WWnotLL/ROS2_tutorial_305/Инструкция по сборке/README.md

# Инструкция по сборке робота BOX305
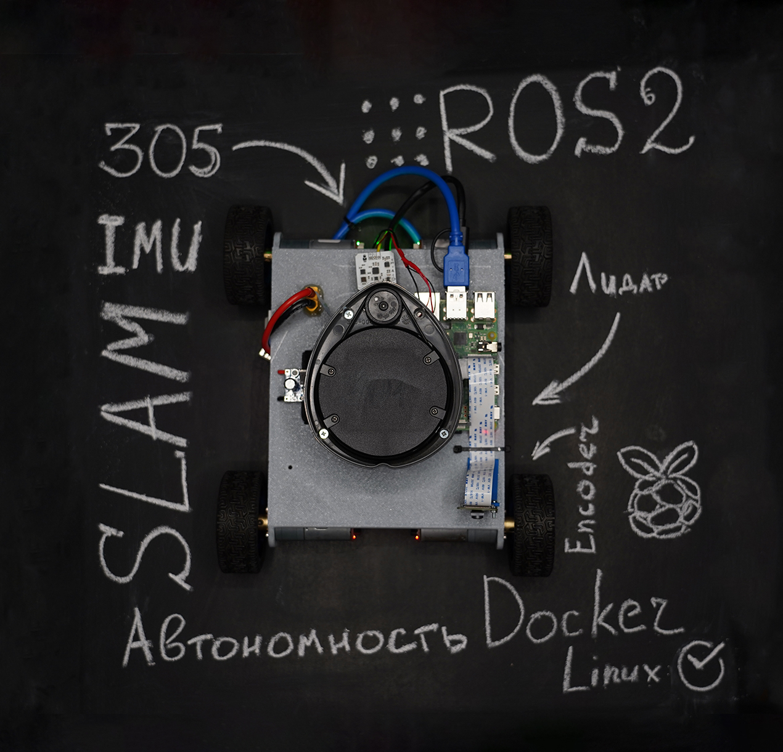
[picture p8: Визитка робота.jpg]

## Вам понядобится следующий набор инструментов
  - Паяльник (думаю понятно для чего 🤔)
  - Дрель (для сверления крепежных отверстий 👍)
  - Клеевой пистолет (на случай, если увлеклись сверлением 🙊)
  - Отвертки (скорее всего PH0 и PH00, но зависит от использованных винтиков 🤷‍♂️)
  - Шестигранники (если не хватит обычных винтиков 😎)
## Корпус

Модель корпуса нашего робота выглядит следующим образом
<br>
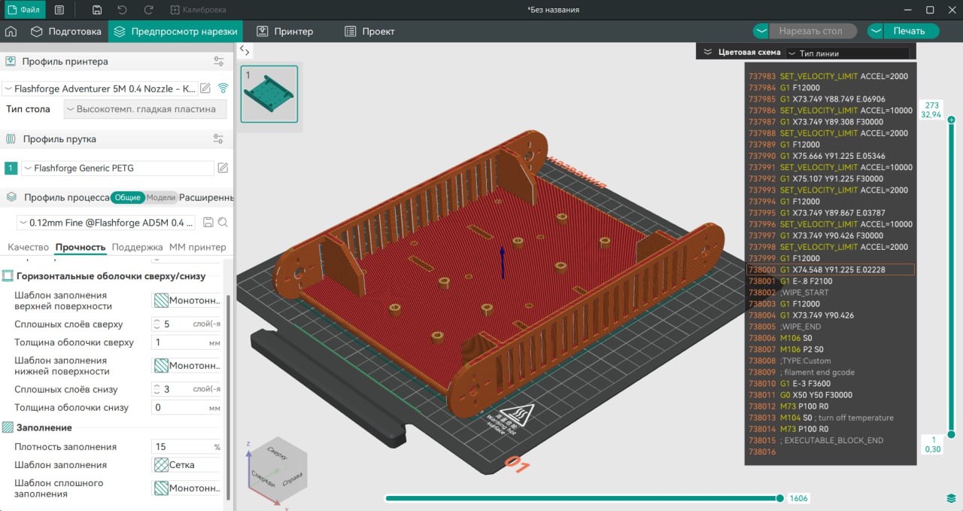
[picture p9: Инструкция по сборке/Иллюстрации к сборке/06_BOX305_модель корпуса.jpg]

<br>
 

Если нет собственных "производственных мощностей", всегда можно воспользоваться услугами __[студий 3D печати](https://uslugi.yandex.ru/213-moscow/category/raznoe/poligraficheskie-uslugi/3dpechat--5635)__

В случае выбора лёгкого пути, смело можно пропускать данный раздел

Для печати корпуса необходим 3D принтер с рабочим полем $200 \times 200$ мм

Выбор материала

Краткая информация об основных видах пластика

| **Параметр** | **ABS** | **PLA** | **PETG** |
|---|---|---|---|
| **Печать** | Капризен, требует закрытого бокса и вентиляции | Очень прост, идеален для новичков | Умеренно прост, требует настройки |
| **Прочность** | Прочный, ударостойкий | Жесткий, но хрупкий при ударе и холоде | Прочный, гибкий, устойчив к излому |
| **Темп. стойкость** | Высокая (-40…+80 °C) | Низкая (~50 °C, "плывёт" на солнце) | Средняя (~80 °C), подходит для большинства задач  |
| **Нетоксичность** | ❌ (выделяет вредные пары) | ✅ (безопасен, с запахом жареной еды) | ✅ (не пахнет, безопасен) |

Для нашего робота будем использовать **PETG**

Для печати корпуса воспользуемся специальной программой __[OrcaSlicer](https://orcaslicer.com/)__

Выставим основные параметры печати следующими:

- Температура экструзии — 215-245°C;

- Температура стола — 20-80°C;

- Процент заполнения — 15%;

## Устанока навесных компонентов

1) Начнём с установки двигателей и колёс.

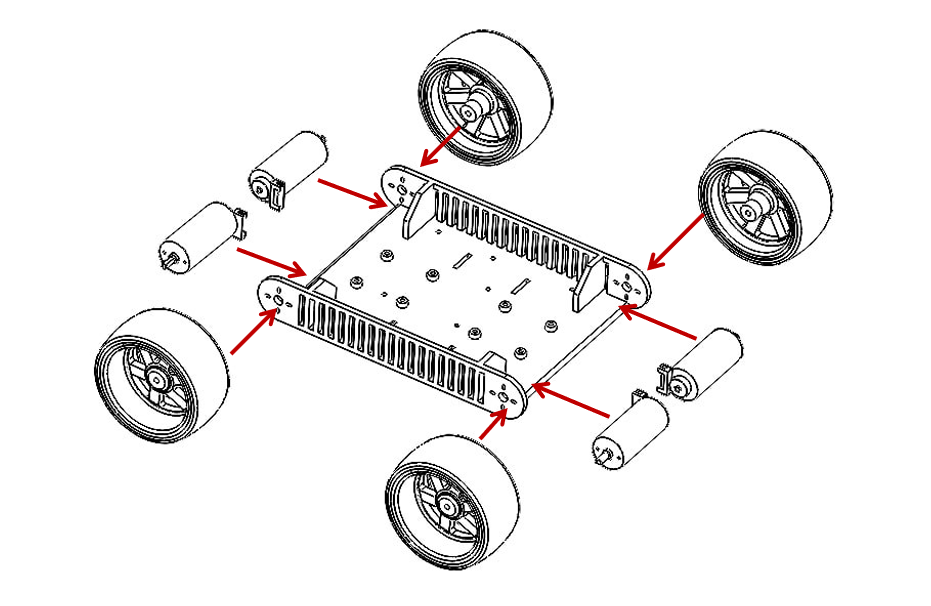
[picture p10: Инструкция по сборке/Иллюстрации к сборке/01_BOX305_разобранный.png]


2) Далее монтируем стойки для установки __raspberry 4__, __лидара__, __DC-DC преобразователя__ и __arduino nano__.
3) Подготавливаем крепление для аккумулятора, мы использовали липучки (прямоугольные вырезы на фото ниже).
4) Устанавливаем разъём подключения аккумулятора XT60 и кнопку питания, спаиваем их
5) Далее приступаем к установке драйверов.

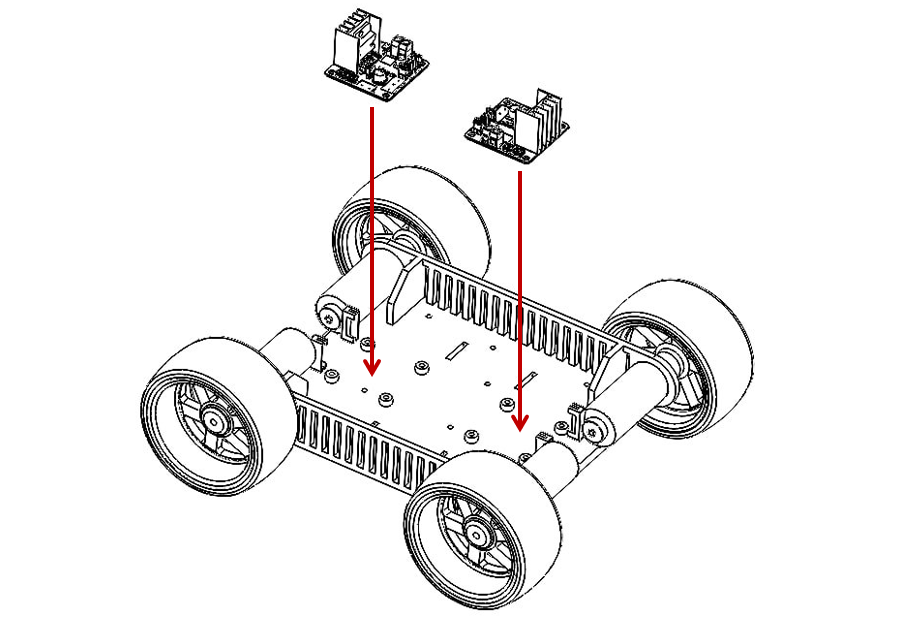
[picture p11: Инструкция по сборке/Иллюстрации к сборке/02_BOX305_установка драйверов.png]
 

6) Монтируем arduino и DC-DC преобразователь
7) Настраиваем преобразователь на **5В**
8) Припаиваем питание к преобразователю и от него к arduino
9) Протягиваем и припаиваем провода от двигателей к драйверам и arduino
10) Устанавливаем Raspberry

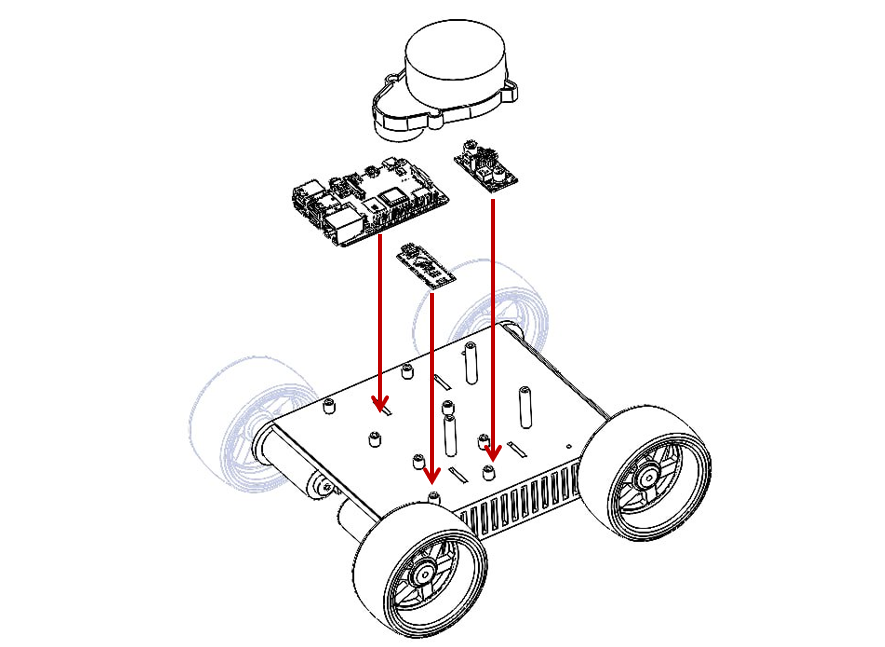
[picture p12: Инструкция по сборке/Иллюстрации к сборке/03_BOX305_установка электроники.png]


11) Наслаждаемся собранным роботом

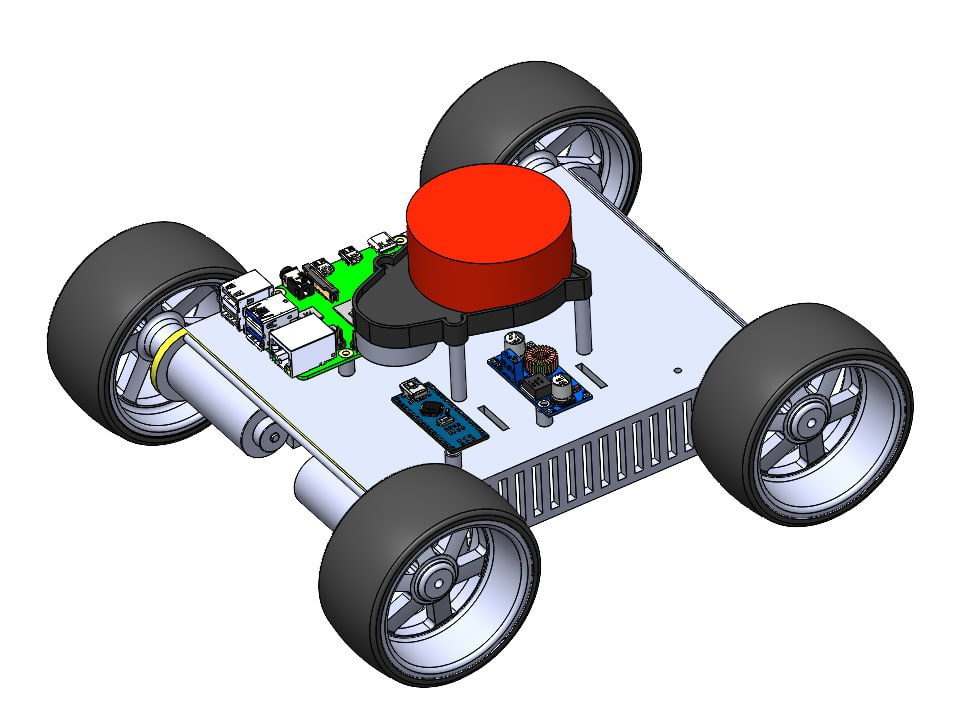
[picture p13: Инструкция по сборке/Иллюстрации к сборке/05_BOX305_модель.jpg]
