WWnotLL/ROS2_tutorial_305/Docker/README.md

# Docker. Краткая информация
__Docker__ — это платформа с открытым исходным кодом для автоматизации разработки, доставки и развёртывания приложений.<br>
<br>
__Контейнер в Docker__ — это изолированное пространство, которое позволяет запускать приложения с их зависимостями отдельно от основной системы. В отличие от традиционных виртуальных машин, контейнеры потребляют меньше ресурсов, так как используют ядро основной системы.<br> 
<br>
Установочный файл __[Docker](https://docker.qubitpi.org/desktop/setup/install/windows-install/)__ <br>
Обратите внимание что при установке необходимо обязательно установить опцию `Use the WSL 2 based engine`. <br>
После установки Docker необходимо зайти в настройки<br>
<br>
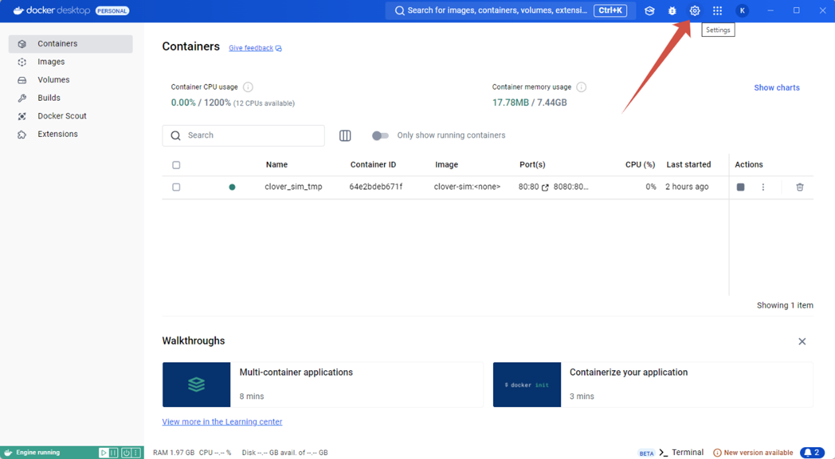
[picture p20: изображения к тексту/настройки докера.png]
Настройки докера
 

<br>

И в пункте __Resources__ подпункте __WSL integration__ проверить что для вашего дистрибутива интеграция включена.
Для работы в самом симуляторе нам потребуется __IDE VS Code c модулем DEV Containers__. Для установки __[VS Code](https://code.visualstudio.com/)__ скачайте установщик по ссылке и запустите его с параметрами по умолчанию
Для установки расширения необходимо запустить __VS Code__ и перейти в раздел __«Расширения» (Ctrl+Shift+X)__. В строке поиска введите __“Remote Development”__ и установите это расширение.

Для более подробного изучения __[Docker](https://github.com/WWnotLL/ROS2_tutorial_305/blob/main/Docker/Docker.docx)__ перейдите по ссылке. <br>
Пример, показывающий как запустить рабочий контейнер, смотрите __[здесь](https://github.com/WWnotLL/ROS2_tutorial_305/blob/main/Docker/Запуск_рабочего_контейнера_Краткая_инструкция.md)__
