WWnotLL/ROS2_tutorial_305/ROS2.md

# ROS (Robot Operating System)<br>
*__Robot Operating System (ROS)__* - это фреймворк (гибкая платформа) для разработки программного обеспечения (ПО) роботов, который ставится на базовую операционную систему, обычно на Linux (Ubuntu).<br>
ROS можно рассматривать, как набор разнообразных инструментов, библиотек и определенных правил, целью которых является упрощение задач разработки ПО роботов.<br>
Он был создан, чтобы стимулировать совместную разработку программного обеспечения робототехники.<br>
Каждая отдельная команда разработчиков и энтузиастов может работать над какой-либо конкретной задачей, но использование единой платформы, позволяет всему сообществу получить и использовать результат их работы для своих личных проектов. <br>
# ROS2 <br>
ROS2 использует те же принципы работы, что и ROS1. В то же время, ROS2 не является частью ROS1. <br>
В отличие от ROS1, cтек которого написан на C++, а клиентские библиотеки на C++ и Python, в ROS2 также используется язык C. <br>
Преимущества использования ROS2: <br>
- позволяет устанавливать безопасные соединения между компонентами системы (нодами);
- взаимодействие осуществляется в режиме «real-time»;
- соединение нескольких роботов в одну сеть упрощен;
- улучшено «качество общения» между нодам (узлами или по простому небольшими командами);<br>

ROS2 реализует real-time взаимодействие через так называемую концепцию DDS (Data Distributed Services) - набор алгоритмов, встраиваемых к разным программам, позволяющий всем программам, имеющим встроенный блок, общаться между собой без центрального сервера.<br>
Для генерации исходного кода для сообщений на разных языках используется протокол ROS MSG. <br>
Для передачи данных между программами существуют следующие инструменты:<br>
1) Топики (topics) – это базовый способ взаимодействия между программами, в этом случае есть программы публикующая (publisher) данные в топик, а есть получающие (subscriber) данные.<br>
Не публикующие и не получающие данные программы ничего не знают об остальных программах, взаимодействующих с топиком. Эта особенность позволяет заменять данные без влияния на другие программы. Например, у нас могут поддерживаться разные инерциальные модули, для каждого из которых существует программа, публикующая данные в один и тот же топик в одном и том же формате.<br>


3) Сервисы – это это механизм синхронного (одновременного) или асинхронного (неодновременного, да-да, логично) вызова процедур между нодами. Они позволяют одной ноде вызывать функцию, которая выполняется в другой ноде.<br>
Сервис состоит из двух компонентов:<br>
- Клиент – компонент, формирующий запрос, отправляющий его серверу и ожидающий ответа.<br> 
- Сервер – компонент, получающий запрос, завершающий вычисление и отправляющий ответ клиенту.<br>

Сервисы часто используются для быстрых задач, которые требуют немедленного ответа.<br>


3) Действия (Actions) в ROS — это механизм связи, предназначенный для управления длительными задачами в распределённой робототехнической системе.<br>
Действия состоят из двух компонентов:<br>
Клиент действия — узел, который запрашивает выполнение цели от своего имени. Он ожидает обратной связи и результата по завершении.<br>
Сервер действий — узел, который принимает цель и выполняет необходимые процедуры. Он отправляет обратную связь по мере выполнения действия и возвращает полный результат, когда цель достигнута.<br>


Дополнительные инструменты, доступные в ROS:
1) Rqt_gui – графический интерфейс представляющий из себя набор плагинов, позволяющий анализировать запущенное окружение ROS.
2) Node Graph – один из плагинов rqt_gui, позволяющий посмотреть запущенные программы и то, как они между собой взаимодействуют.
3) RVIZ – инструмент визуализации стандартных сообщений ROS. 
4) Nav2 – набор программ, используемый для навигации робота, его перемещения и предотвращения столкновении.
