WWnotLL/ROS2_tutorial_305/Docker/Установка Docker на Ubuntu.md

# Инструкция по запуска Docker
<br>
## Дисклеймер
### В основном в этой инструкции будут представлены картинки успешного выполнения команды, в иных случаях будет дано более подробное описание к картинкам
1. Для начала обновите список пакетов и установите обновления:

```
sudo apt update
```

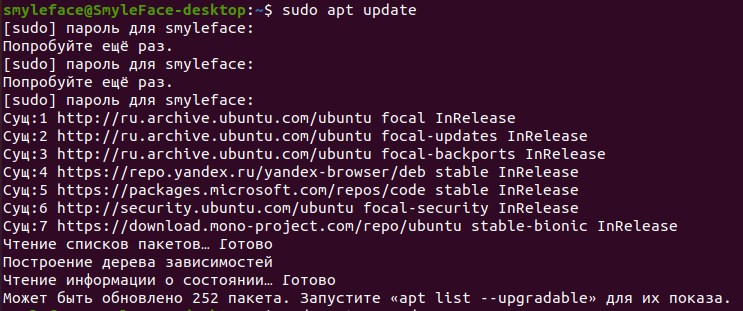
[picture p27: Docker/Фото к инструкции/1.png]


```
sudo apt upgrade -y
```

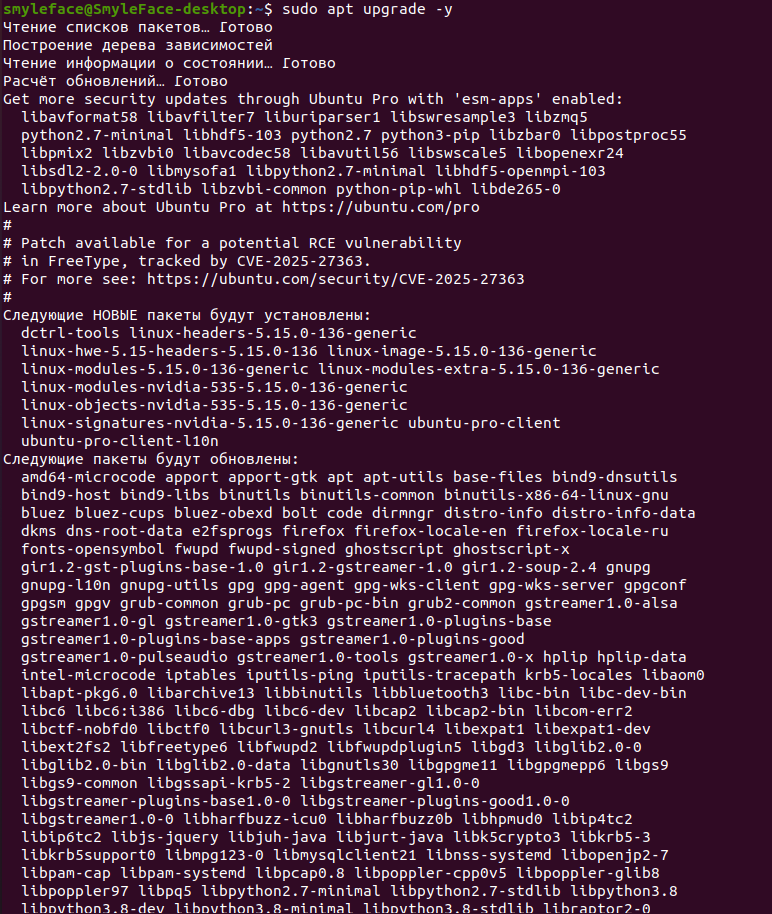
[picture p28: Docker/Фото к инструкции/2.png]


Если выполнение программы прошло успешно, то выйдет примерно такое сообщение:
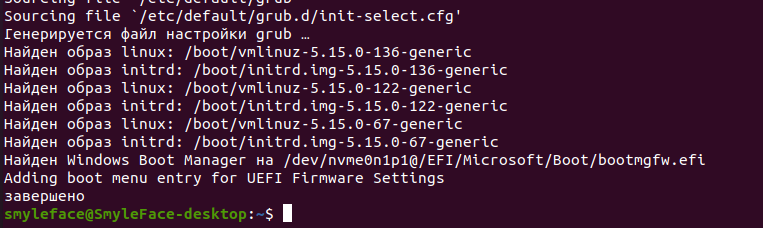
[picture p29: Docker/Фото к инструкции/3.png]


2. Установите необходимые зависимости
```
sudo apt install -y apt-transport-https ca-certificates curl software-properties-common
```
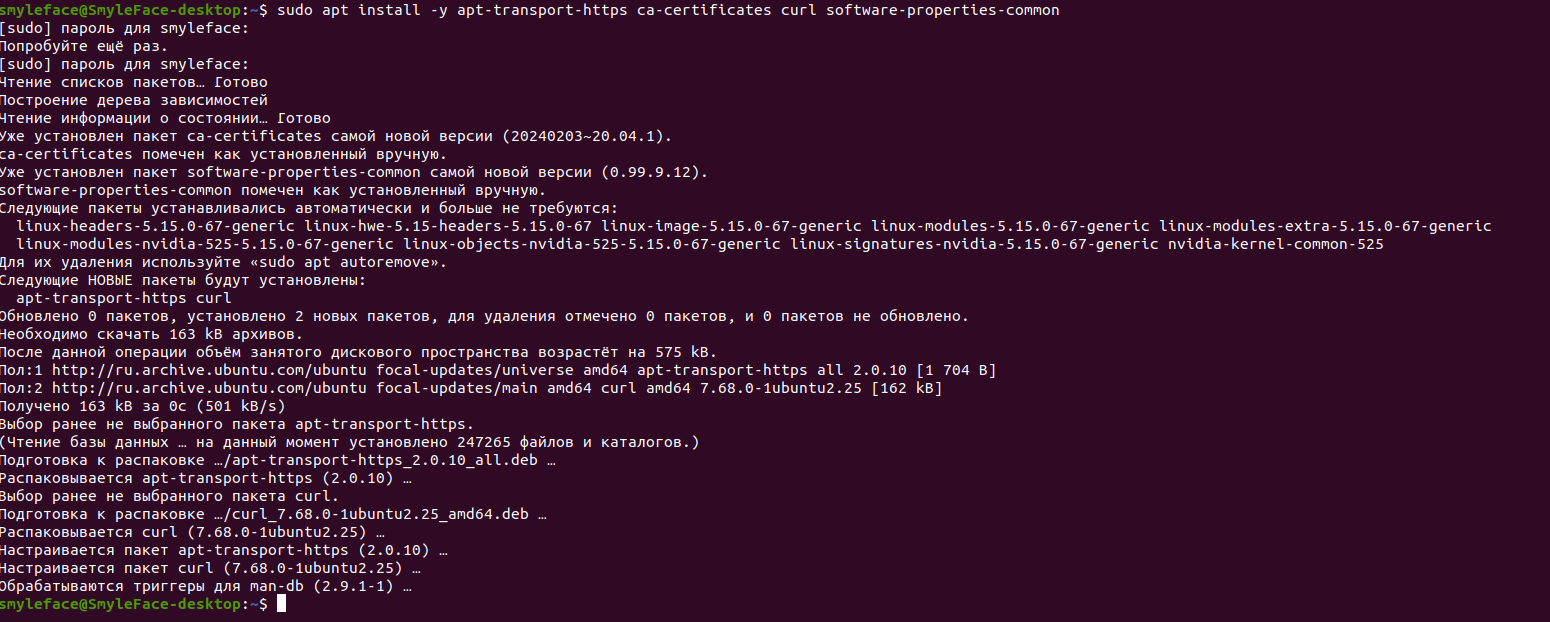
[picture p30: Docker/Фото к инструкции/4.png]

3. Добавьте официальный GPG-ключ Docker
```
curl -fsSL https://download.docker.com/linux/ubuntu/gpg | sudo gpg --dearmor -o /usr/share/keyrings/docker-archive-keyring.gpg
```

4. Добавьте репозиторий Docker в APT
```
echo "deb [arch=$(dpkg --print-architecture) signed-by=/usr/share/keyrings/docker-archive-keyring.gpg] https://download.docker.com/linux/ubuntu $(lsb_release -cs) stable" | sudo tee /etc/apt/sources.list.d/docker.list > /dev/null
```

5. Обновите пакеты и установите Docker
```
sudo apt update
```
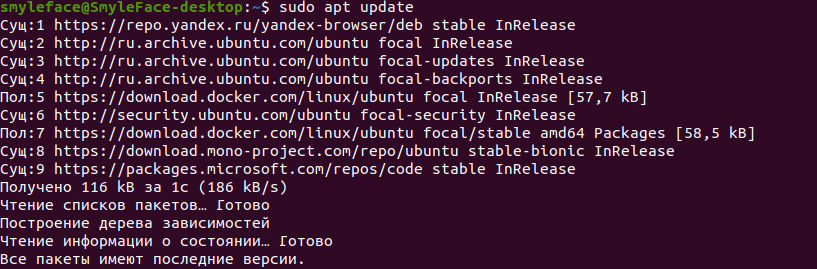
[picture p31: Docker/Фото к инструкции/7.png]

```
sudo apt install -y docker-ce docker-ce-cli containerd.io
```
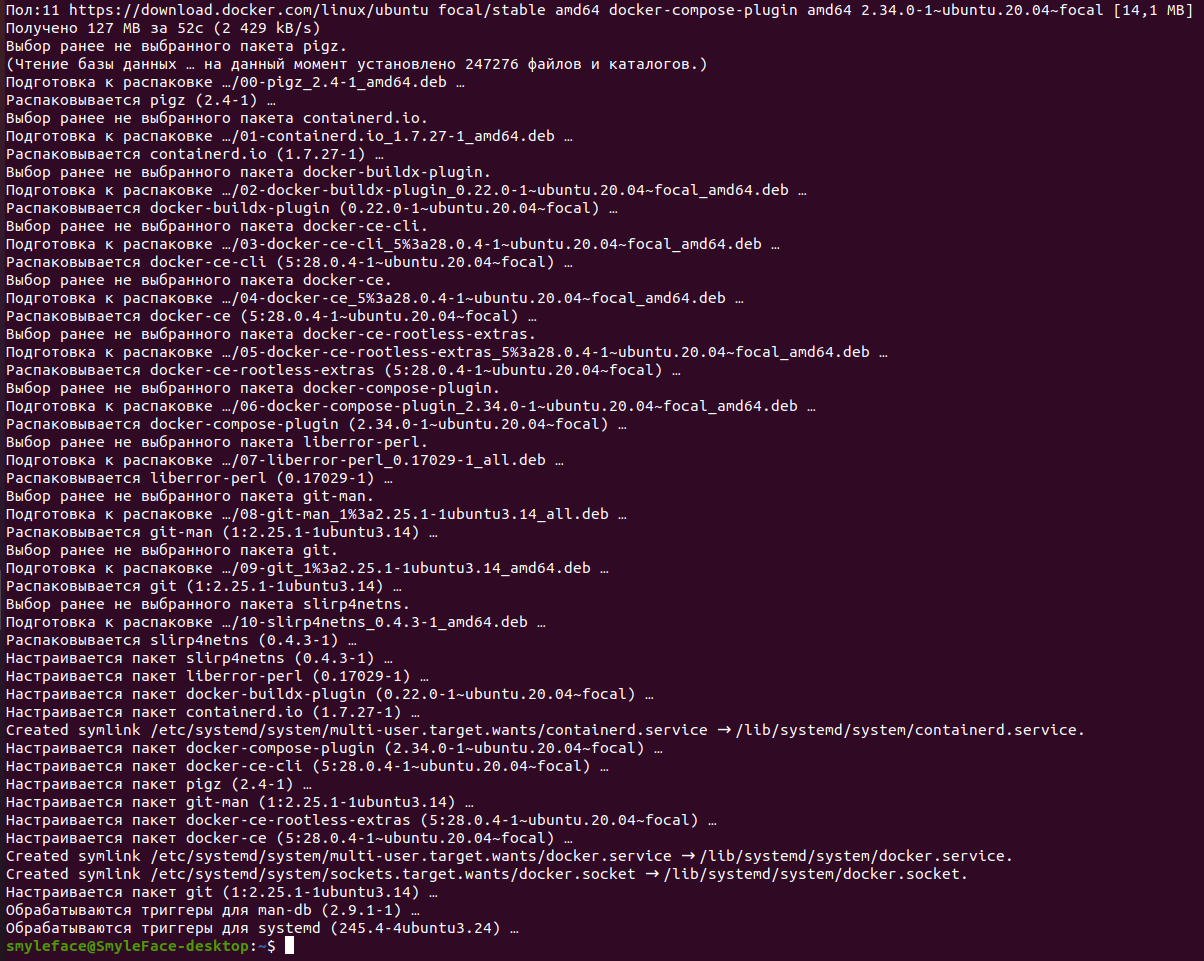
[picture p32: Docker/Фото к инструкции/8.png]

6. Проверьте, что Docker работает
```
sudo systemctl status docker
```
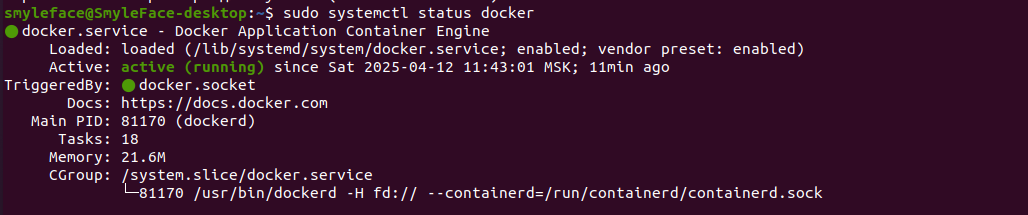
[picture p33: Docker/Фото к инструкции/24.png]

8. Проверьте установку
```
docker --version
```
