WWnotLL/ROS2_tutorial_305/Установка Linux/README_Linux.md

# Инструкция по установке Linux
<br>

В этом курсе мы предлагаем Вам использовать ___WSL2___.<br>
___WSL2___ - это тип дистрибутива (набора установочных программ) по умолчанию при установке дистрибутива ___Linux___. ___WSL2___ использует технологию виртуализации для запуска ядра ___Linux___ в упрощенной служебной виртуальной машине. То есть у вас будет возможность запускать ___Linux___ поверх вашем ___Windows___, не устанавливая вторую операционную систему. <br>
становка ___wsl2___ выполнятся на операционных системах ___Windows 10___ и ___Windows 11___. В окне терминала ___PowerShell___ или ___cmd___ последовательно введите команды (для установки требуется подключение к интернету):<br> 

```
wsl --install
```
```
wsl --set-default-version 2
```
```
wsl --list --online
```
```
wsl --install Ubuntu-22.04
```
```
wsl --install
```

В результате на вашей системе будет установлена ___wsl2___. Для более удобной работы с ___wsl___ установим программу ___Windows Terminal___<br>
Программа ___Windows Terminal___ устанавливается через ___Microsoft Store___. В строке поиска ___Windows___ напишите ___Microsoft Store___ и откройте приложение магазина, в поиске магазина напишите ___Windows Terminal___. Первый полученный результат будет нужной программой нажмите на результат поиска и нажмите кнопку ___"Установить"___.
