WWnotLL/ROS2_tutorial_305/Docker/doc.docx

Скачать установщик (?)

Сначала обновите список пакетов и установите обновления:

```sudo apt update```


```sudo apt upgrade -y```


Если выполнение программы прошло успешно, то выйдет примерно такое сообщение:


2. Установите необходимые зависимости

```sudo apt install -y apt-transport-https ca-certificates curl software-properties-common```


3. Добавьте официальный GPG-ключ Docker

```curl -fsSL https://download.docker.com/linux/ubuntu/gpg | sudo gpg --dearmor -o /usr/share/keyrings/docker-archive-keyring.gpg```

4. Добавьте репозиторий Docker в APT

```echo "deb [arch=$(dpkg --print-architecture) signed-by=/usr/share/keyrings/docker-archive-keyring.gpg] https://download.docker.com/linux/ubuntu $(lsb_release -cs) stable" | sudo tee /etc/apt/sources.list.d/docker.list > /dev/null```

5. Обновите пакеты и установите Docker

```sudo apt update```


```sudo apt install -y docker-ce docker-ce-cli containerd.io```


6. Проверьте, что Docker работает

```sudo systemctl status docker```

Значит ли это что все норм?

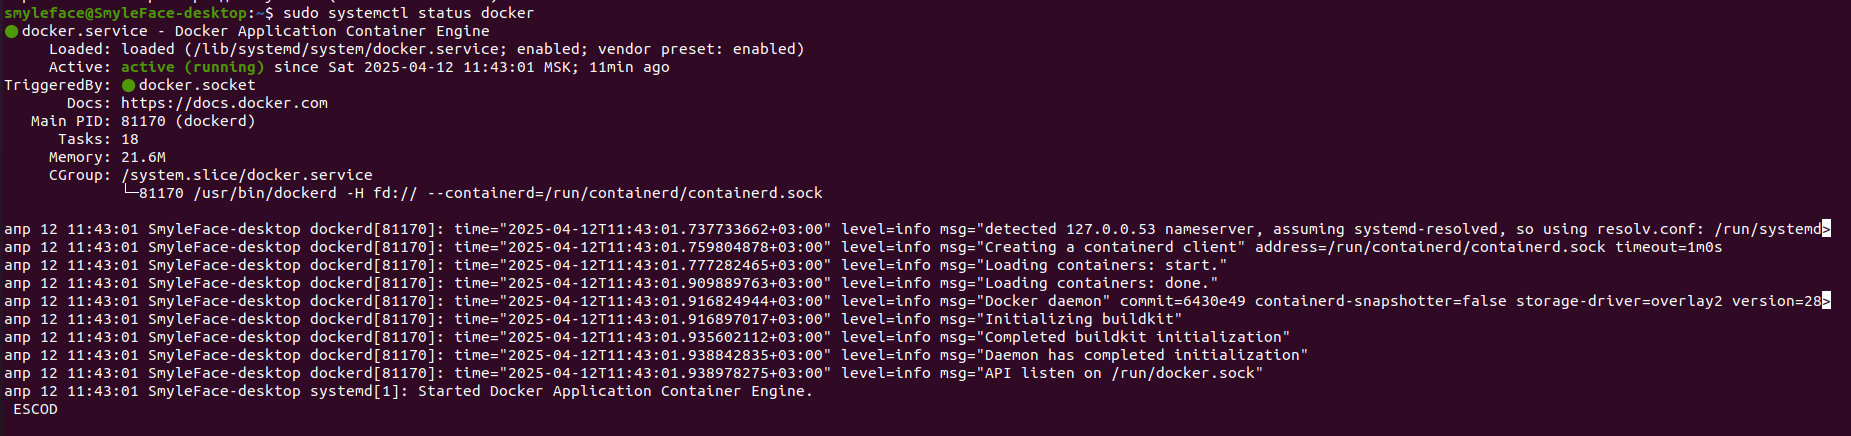
[picture p34: figure]

8. Проверьте установку

```

docker --version

docker run hello-world

```

Пример пути к проекту

Если при запуске ./build_docker.bash вышло след сообщение

напишите ls

белым выделены файлы, в доступе к которым отказано. Для исправления этой ошибки пропишите chmod +x *.bash,

где chmod — изменить режим, +х — разрешить в доступе, *.bash — все, что заканчивается на bash

файлы выделены зеленым — доступ предоставлен

./docker_build.bash

Для начала нужно перейти в нужную папку командой cd

Кстати, чтобы не прописывать постоянно cd, можно пользоваться табуляцией. Пишем в терминале `cd «Начало названия папки»`,
нажимаем TAB (у меня это клавиша над CAPS LOCK со стрелочками) и произойдет автоматическое дополнение названия папки

Прописываем ```./docker_build.bash``` Успешное выполнение команды будет выглядеть так:


Если возникла эта ошибка, то нужно перезайти в контейнер, напишите ```exit```, а после ./into.bash

Запускаем симуляции в каждом из окон


Результат работы Gazebo


Рез граф интерфейс


Для завершения работы симуляторов в каждой из панелей нужно нажать CTRL + C (не забудьте нажать на само окошко)

Появление этого сообщения говорит о завершении работы симуляторов.

Кстати, если несколько раз задавали различные команды в терминале, можно использовать команду clear, которая очистит терминал от «мусора»
