WWnotLL/ROS2_tutorial_305/photo_2025-04-05_16-00-42.jpg

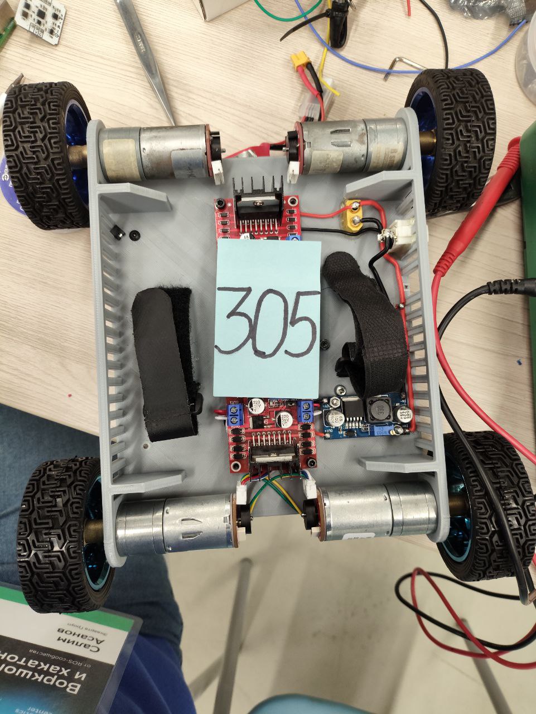
photo_2025-04-05_16-00-42.jpg
