WWnotLL/ROS2_tutorial_305/изображения к тексту/Формальная схема Docker.png

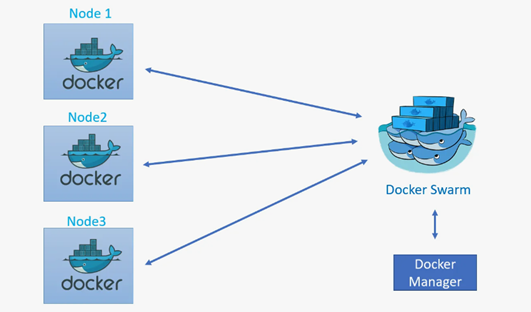
изображения к тексту/Формальная схема Docker.png
