WWnotLL/ROS2_tutorial_305/Фото элементов/Arduino nano.png

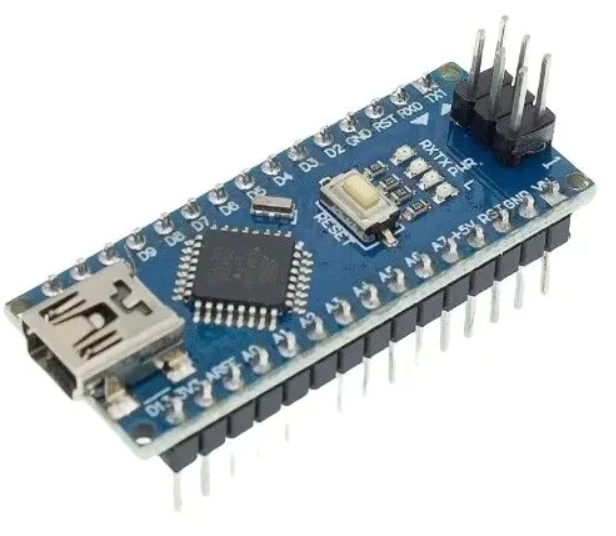
Фото элементов/Arduino nano.png
