WWnotLL/ROS2_tutorial_305/Фото элементов/DC-DC 5A XL4005.png

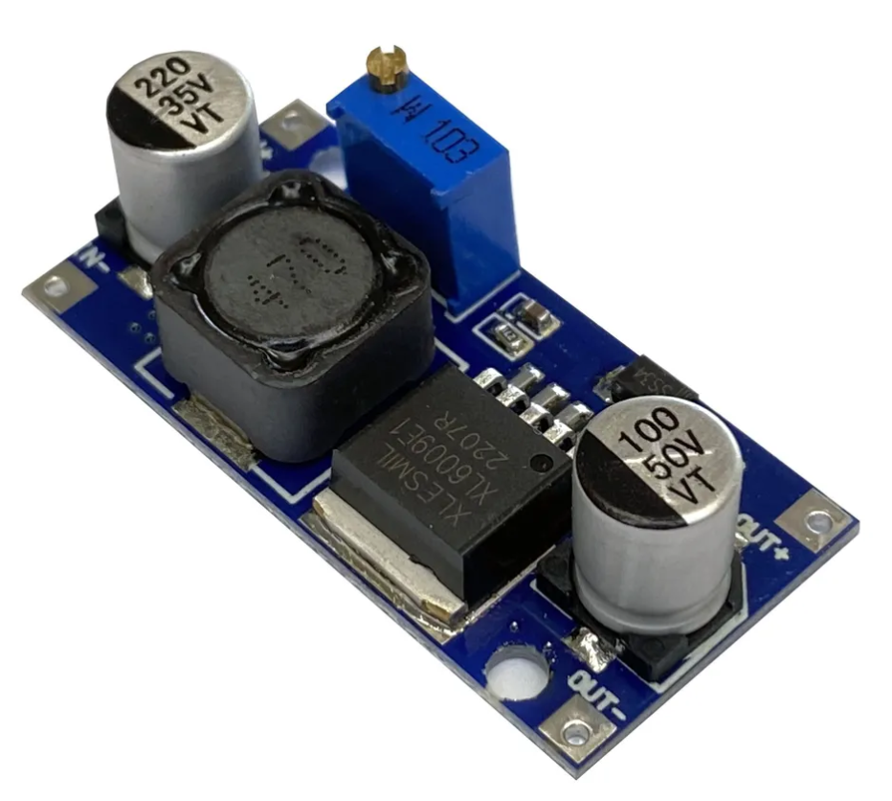
Фото элементов/DC-DC 5A XL4005.png
