WWnotLL/ROS2_tutorial_305/Фото элементов/Li-Po аккумулятор.png

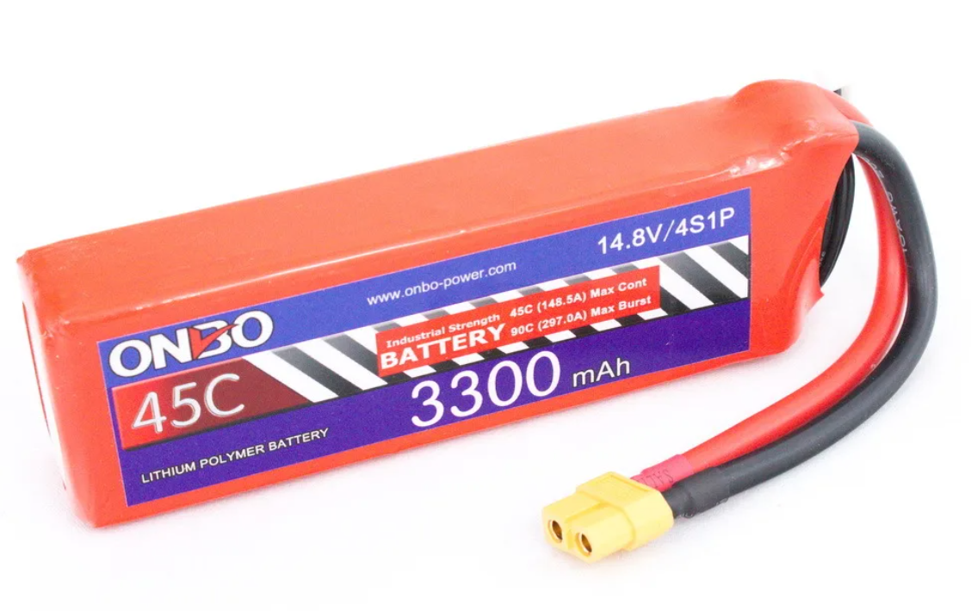
Фото элементов/Li-Po аккумулятор.png
