WWnotLL/ROS2_tutorial_305/Фото элементов/Raspberry Pi 4.png

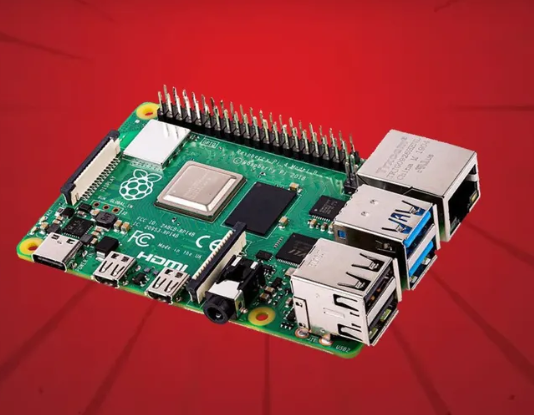
Фото элементов/Raspberry Pi 4.png
