WWnotLL/ROS2_tutorial_305/Фото элементов/выключатель.png

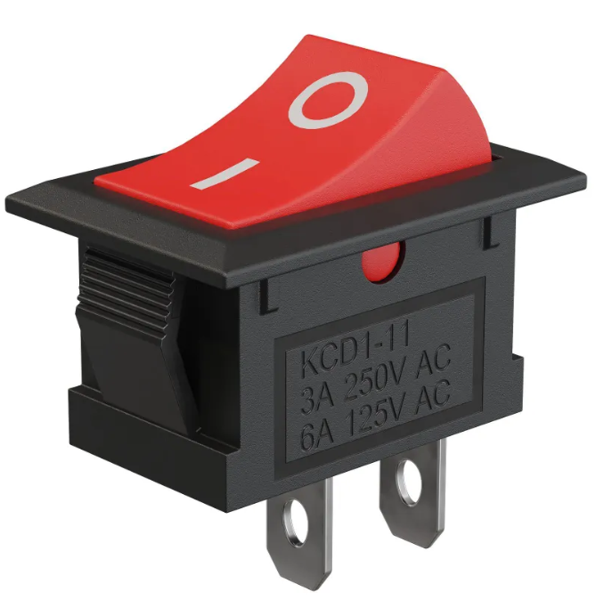
Фото элементов/выключатель.png
