WWnotLL/ROS2_tutorial_305/Фото элементов/Двигатель JGA-370B.png

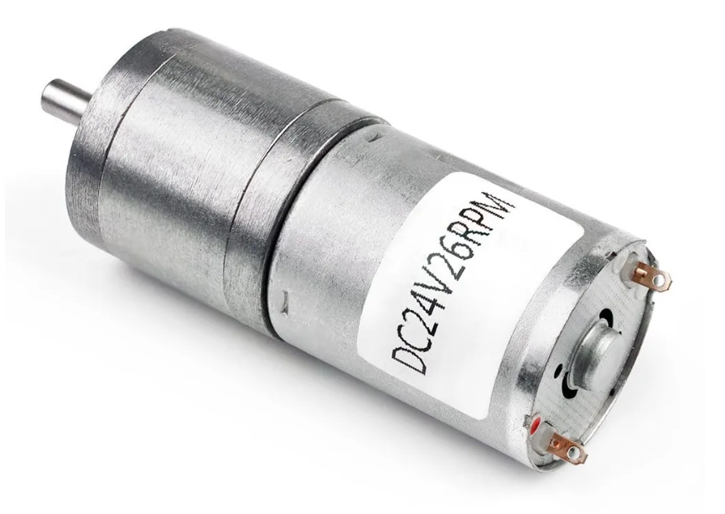
Фото элементов/Двигатель JGA-370B.png
