WWnotLL/ROS2_tutorial_305/Фото элементов/Драйвер для двигателя.png

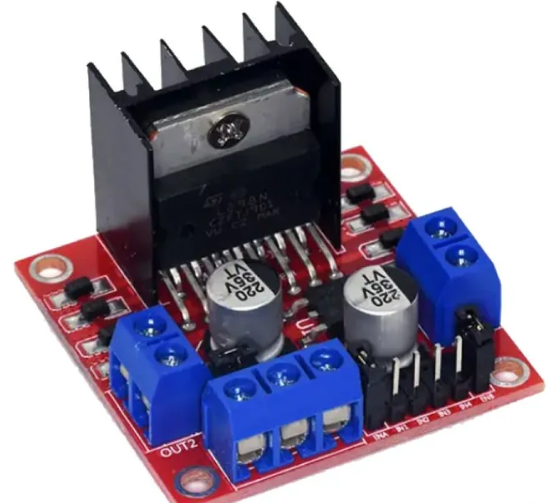
Фото элементов/Драйвер для двигателя.png
