WWnotLL/ROS2_tutorial_305/Фото элементов/колесо.png

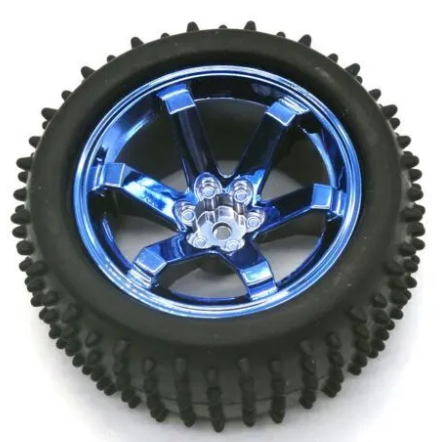
Фото элементов/колесо.png
