WWnotLL/ROS2_tutorial_305/Фото элементов/Лидар.png

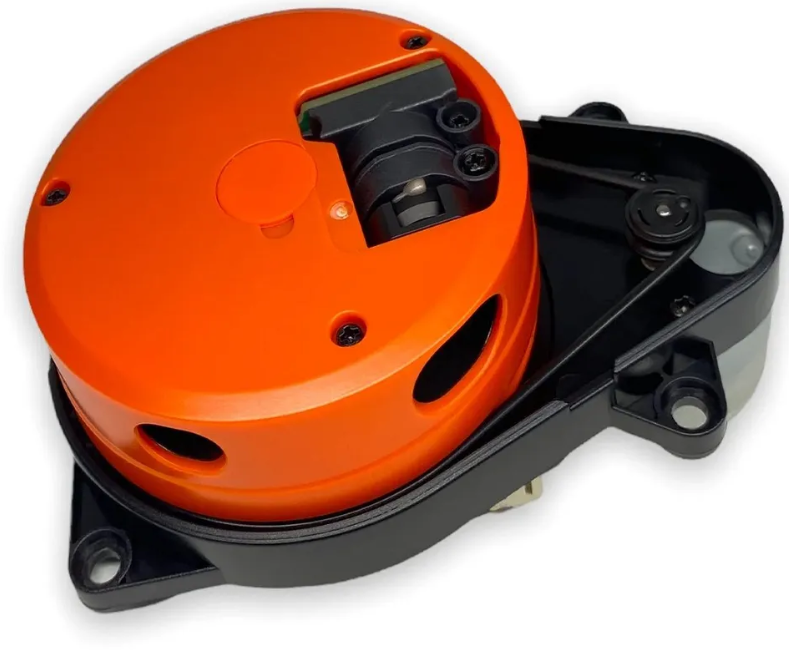
Фото элементов/Лидар.png
