WWnotLL/ROS2_tutorial_305/Фото элементов/Навигационный модуль.png

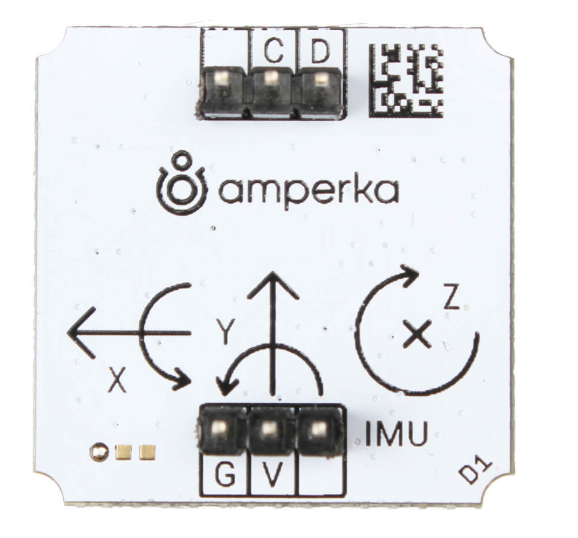
Фото элементов/Навигационный модуль.png
