WWnotLL/ROS2_tutorial_305/Фото элементов/Провода для пайки.png

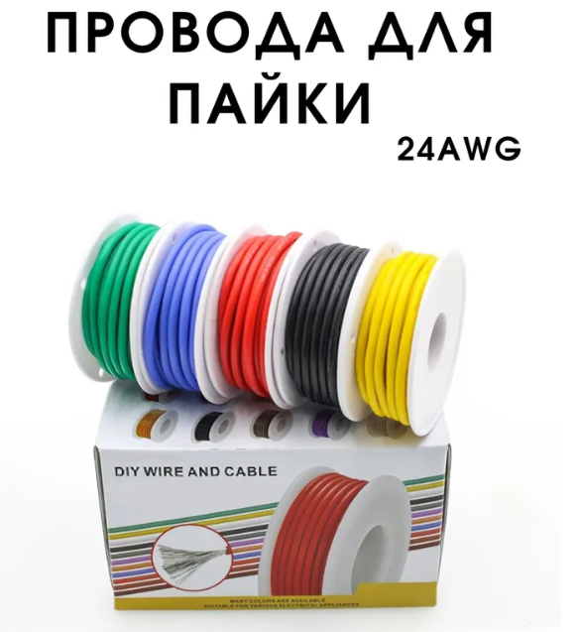
Фото элементов/Провода для пайки.png
