WWnotLL/ROS2_tutorial_305/Фото элементов/Ультразвуковой дальномер HC-SR04.png

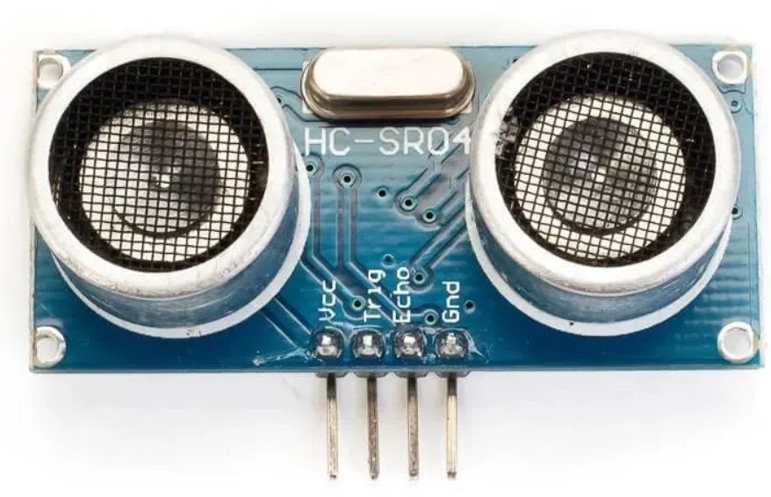
Фото элементов/Ультразвуковой дальномер HC-SR04.png
