WWnotLL/ROS2_tutorial_305/(threads)

Thread 1 (2025-04-09):

Для сборки понадобится

KLelkov, 2025-04-09:
Предлагаю добавить такой раздел, так как в инструкции сказано что нужно паять провода например. Значит как минимум для сборки нужны пояльник, флюс, припой.

Можно добавить также раздел "Дополнительно" и туда скидывать всякие доп вещи вроде техники лужения проводов. Как пример:
https://clover.coex.tech/ru/tinning.html

Closed 2025-04-13.

Thread 3 (2025-04-09):

Примеры кода

KLelkov, 2025-04-09:
Понятно, что у нас в репозитории будет лежать полная прошивка, но можно добавить отдельные модули с примерами кода работы с imu, одометрами, лидаром т.п. Вроде примеров из ардуино IDE.
Понятно что сейчас не всё ещё готово, но что-то уже есть, можно начинать заполнять. К каждому примеру нужно будет свой readme с пояснениями дать (или можно просто писать комментарии по коду, а потом скопировать в ридми)
Предлагаю такую структуру каталогов:
- examples/
- - arduino/
- - raspberry/

Closed 2025-04-13.

Thread 4 (2025-04-09):

Поправить оформление

KLelkov, 2025-04-09:
Местами руководство выглядит как "стена текста", нужно бы его "оживить". Формулы тоже надо как-то преобразовать, может в виде картинок дать - чтобы красиво было.

Closed 2025-04-12.
