WWnotLL/ROS2_tutorial_305/(commit log)

2025-04-05 Промежуточный вид робота команды 305))
2025-04-05 Добавлена таблица компонентов.md
2025-04-06 Create Формальная схема Docker
2025-04-06 добавлена иллюстрация настройки докера.md
2025-04-06 добавили докер.md
2025-04-06 Добавлены иллюстрации по ROS2.md
2025-04-06 Загружена инструкция по сборке.md
2025-04-06 Добавлена эл схема.md
2025-04-06 Добавлена мат модель.md
2025-04-12 Добавил набор инструментов.md
2025-04-12 Create Описание работы с микроконтроллером.md
2025-04-12 Create Установка Docker на Ubuntu.md
2025-04-12 Update Установка Docker на Ubuntu.md
